bytecod3/Hydros/hardware/hydros-v1-png-top.png

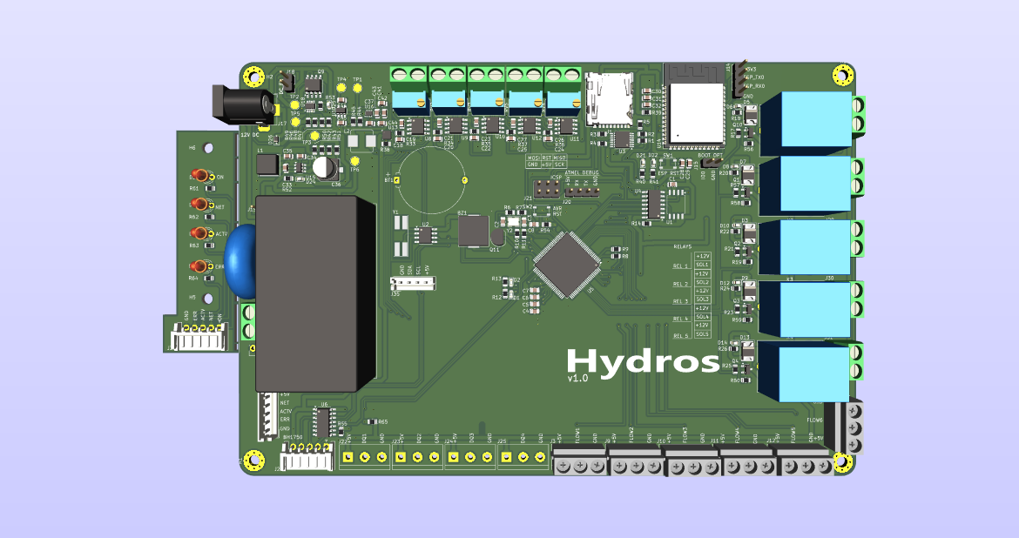
hardware/hydros-v1-png-top.png
