bytecod3/Hydros/hardware/hydros-v1-png.png

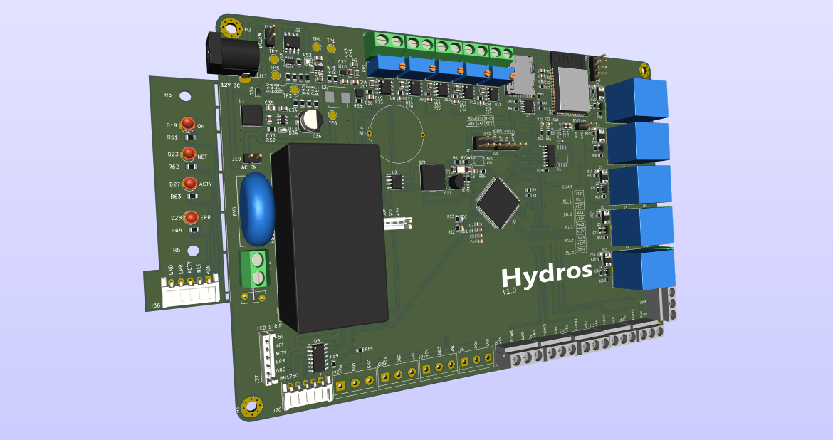
hardware/hydros-v1-png.png
