bytecod3/Hydros/README.md

### Introduction
Hydros

### Enabling floating point on MicroChip Studio 7
Refer to this article:
https://startingelectronics.org/articles/atmel-AVR-8-bit/print-float-atmel-studio-7/
