bytecod3/Hydros/hydro-switch/assets/system-diagram.pdf

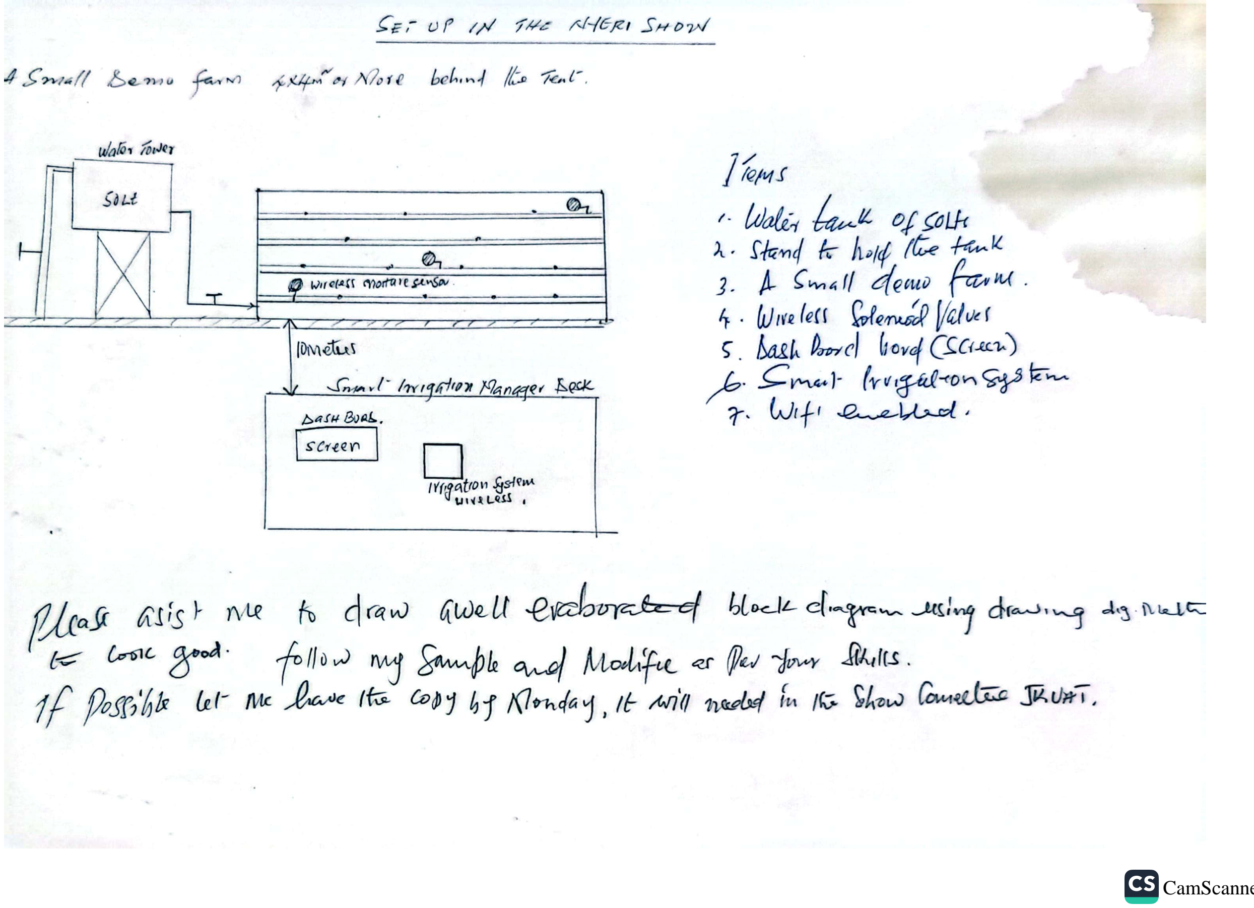
[picture p3: page 1]

CamScanner (https://v3.camscanner.com/user/download)
