bytecod3/Hydros/brainstorm/psu-1.jpg

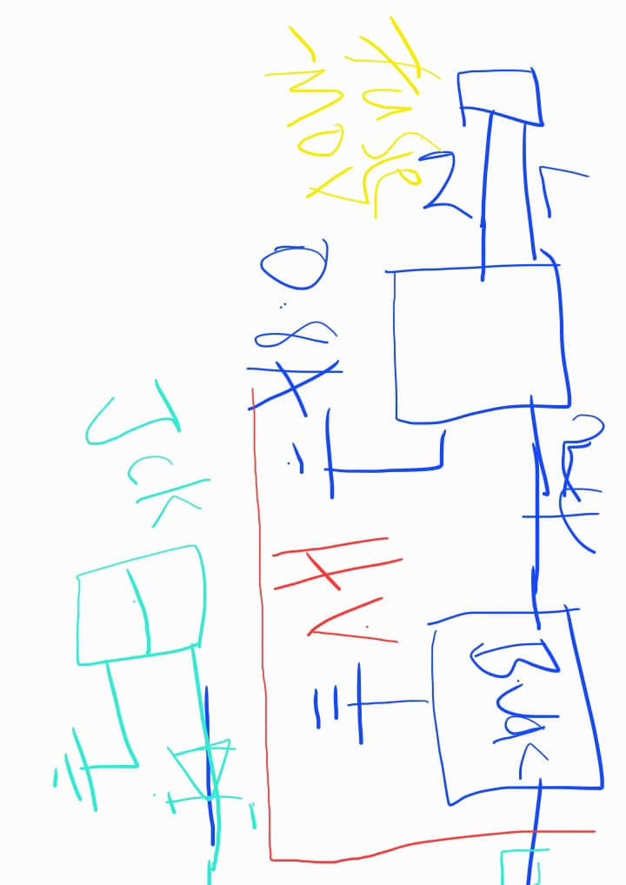
brainstorm/psu-1.jpg
