bytecod3/Hydros/brainstorm/psu-2.jpg

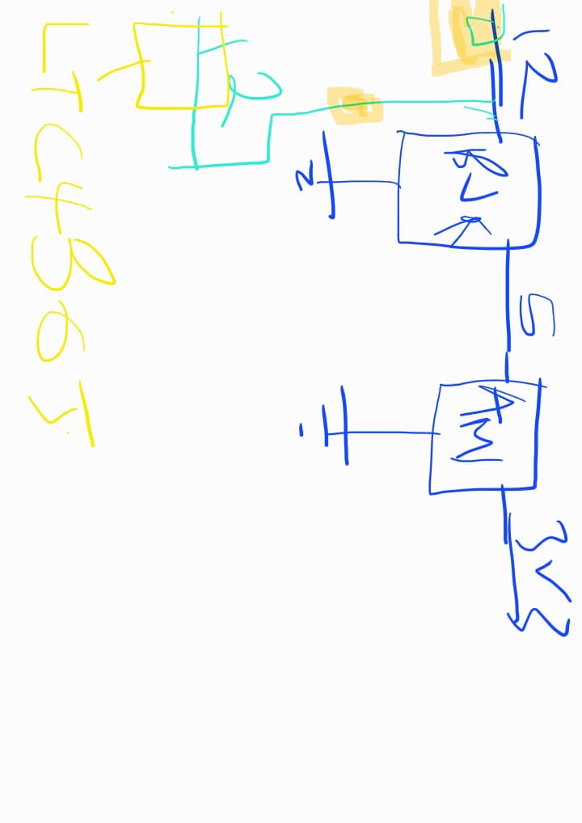
brainstorm/psu-2.jpg
