bytecod3/Hydros/hydro-switch/assets/ortho.png

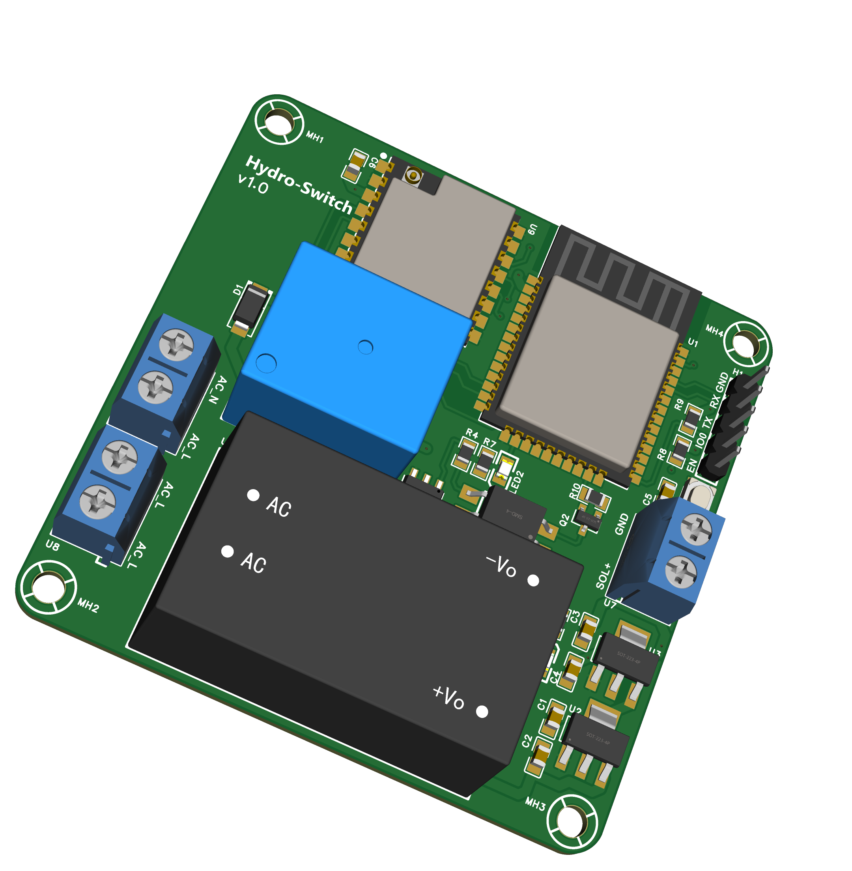
hydro-switch/assets/ortho.png
