bytecod3/Hydros/hydro-switch/assets/solenoid-2.jpg

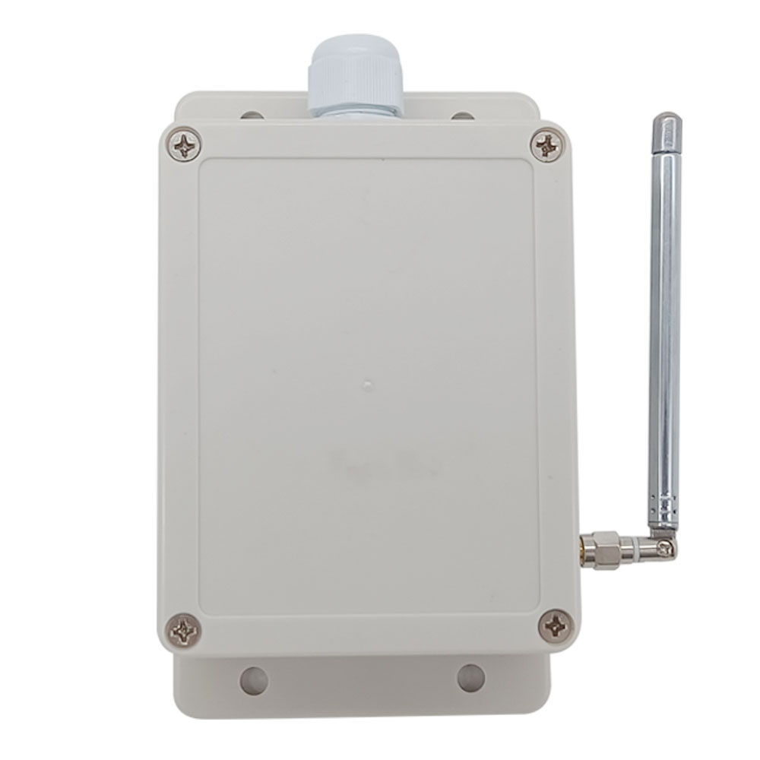
hydro-switch/assets/solenoid-2.jpg
