bytecod3/Hydros/hydro-switch/assets/solenoid-3.jpg

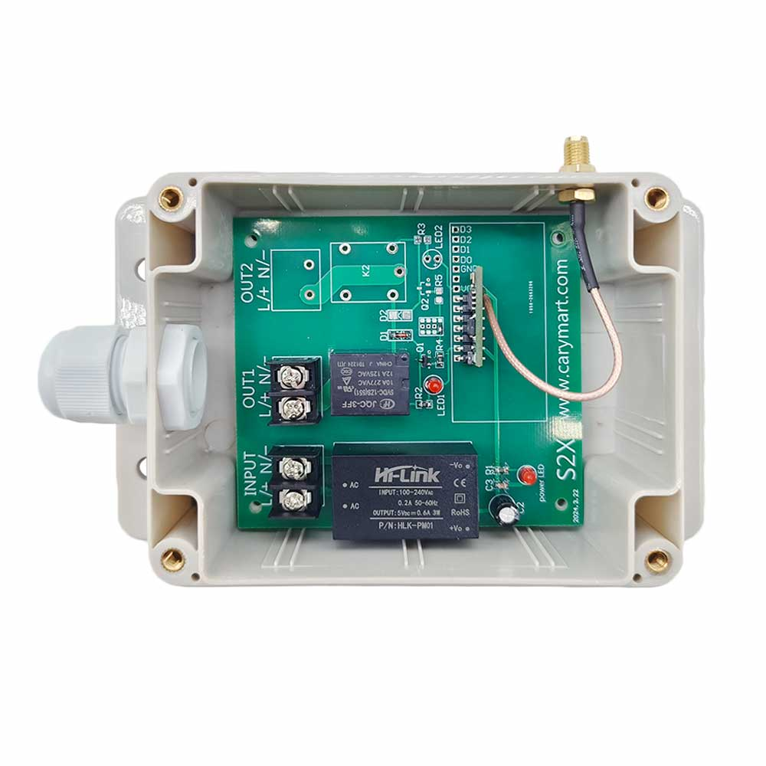
hydro-switch/assets/solenoid-3.jpg
