bytecod3/Hydros/hydro-switch/assets/solenoid-cct.jpg

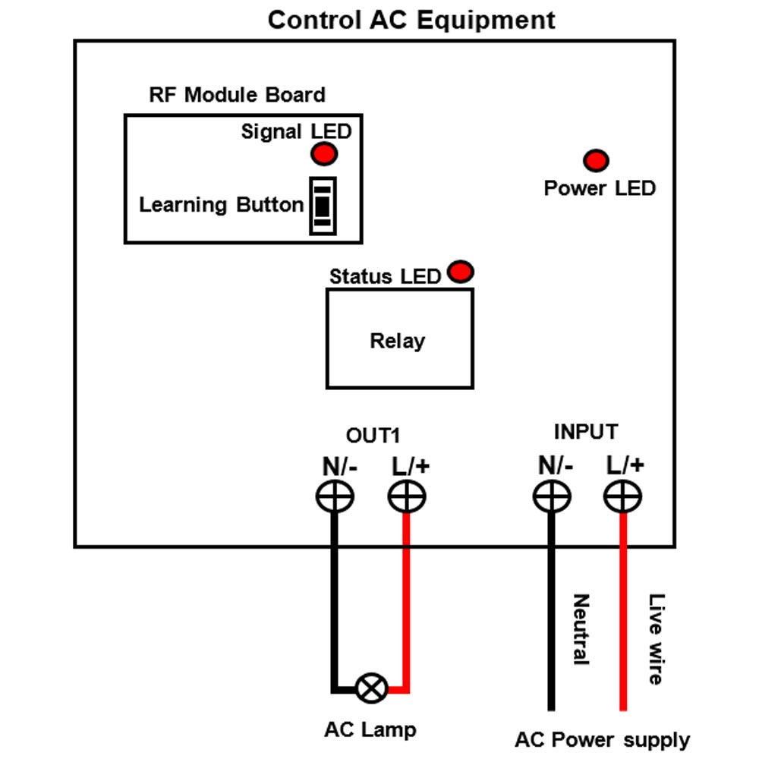
hydro-switch/assets/solenoid-cct.jpg
