bytecod3/Hydros/hydro-switch/assets/solenoid.jpg

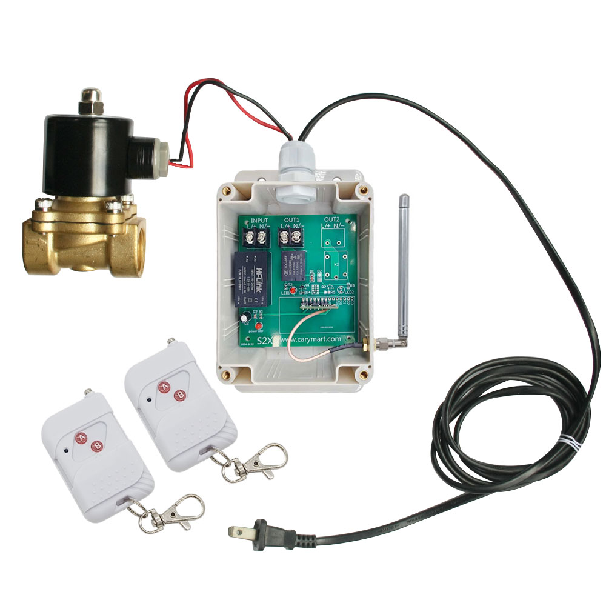
hydro-switch/assets/solenoid.jpg
