bytecod3/Hydros/hydro-switch/assets/top.png

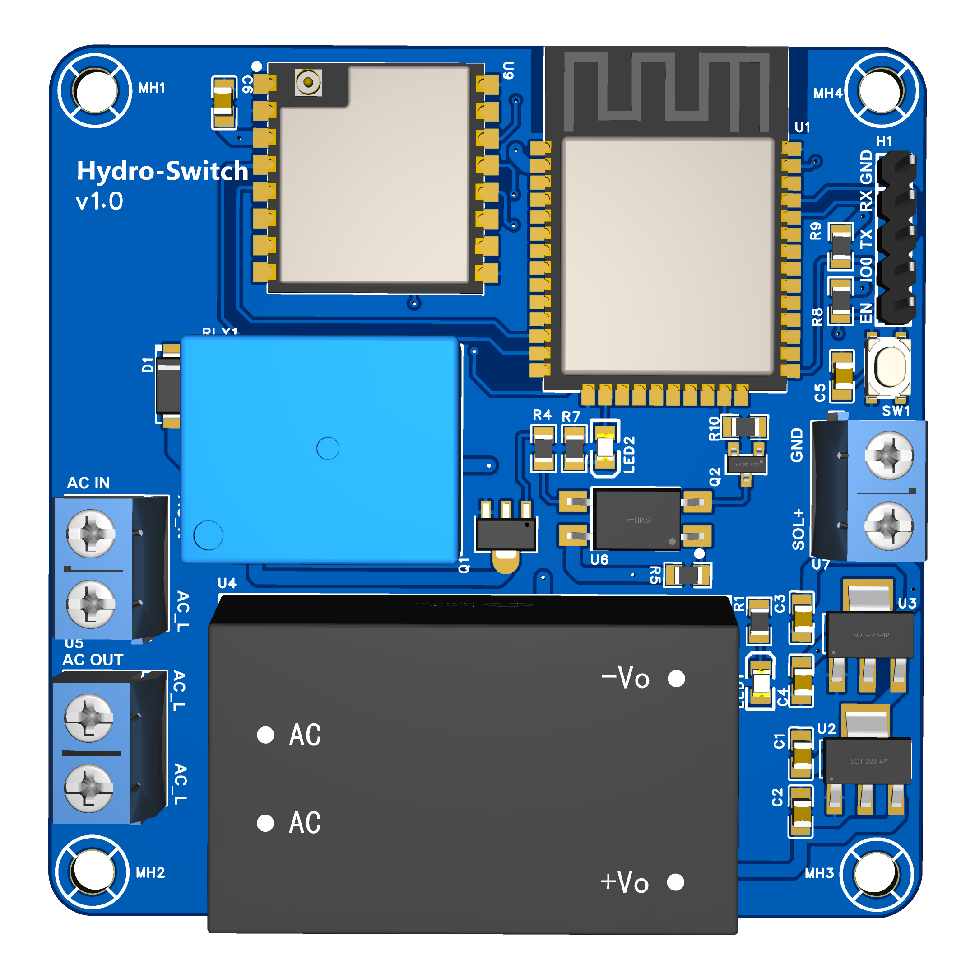
hydro-switch/assets/top.png
