bytecod3/Hydros/hydro-switch/assets/wireless-solenoid-valve.png

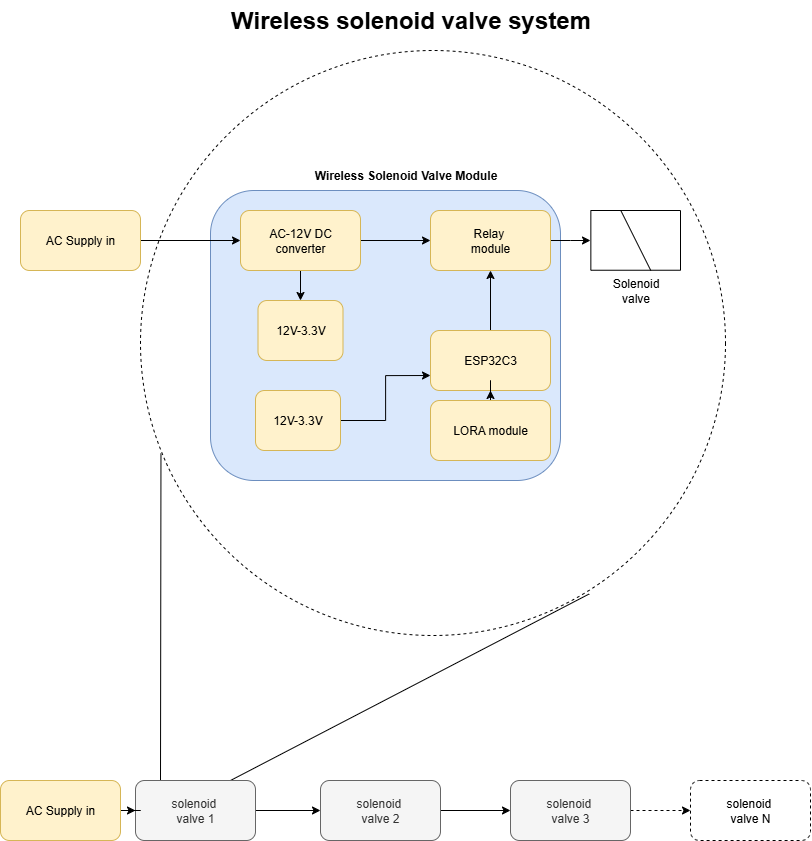
hydro-switch/assets/wireless-solenoid-valve.png
