bytecod3/Hydros/images/home-side.png

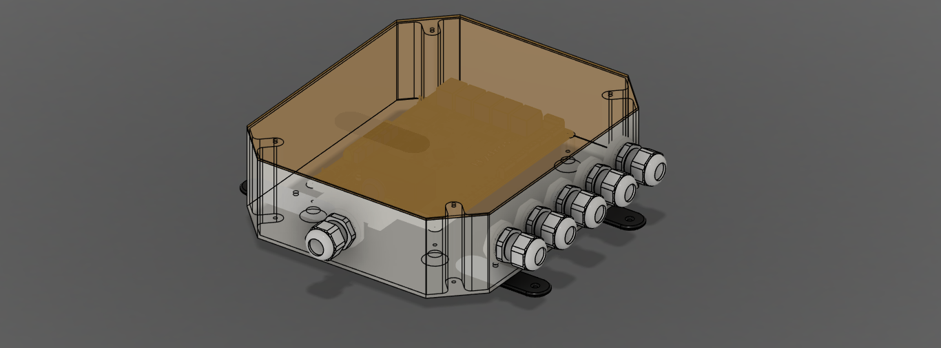
images/home-side.png
