bytecod3/Hydros/images/home.png

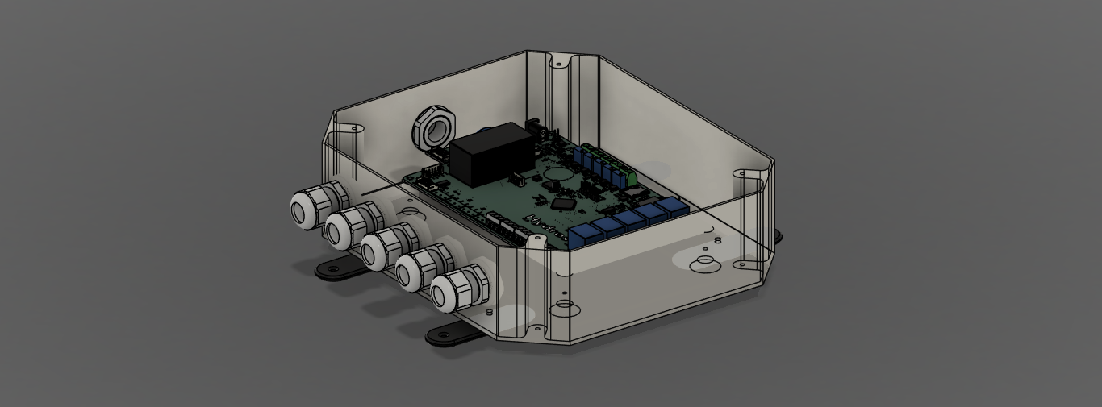
images/home.png
