bytecod3/Hydros/images/top.png

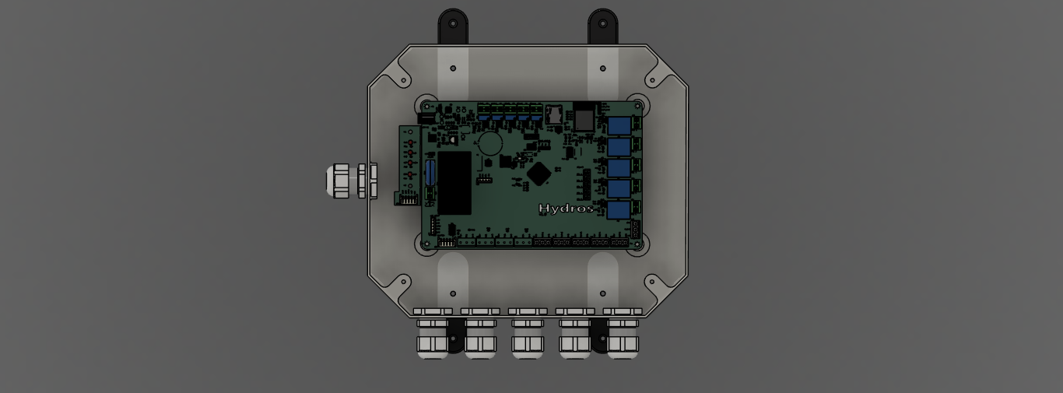
images/top.png
