bytecod3/Hydros/hydro-switch/assets/smart-irrigation-manager-setup.png

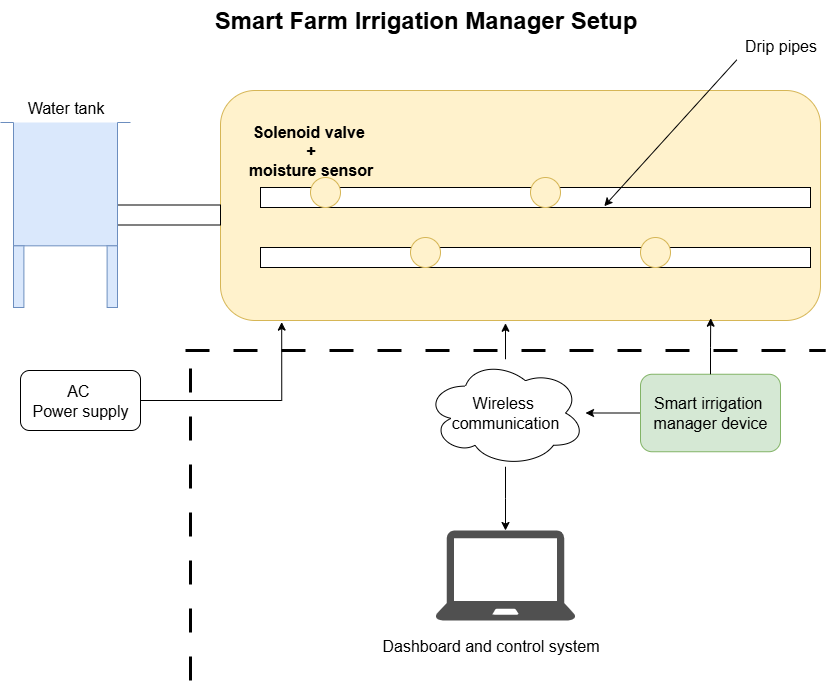
hydro-switch/assets/smart-irrigation-manager-setup.png
