bytecod3/Hydros/hydro-switch/schematics/hydroswitch-v1.pdf

POWER SUPPLY | DEBUG HEADER

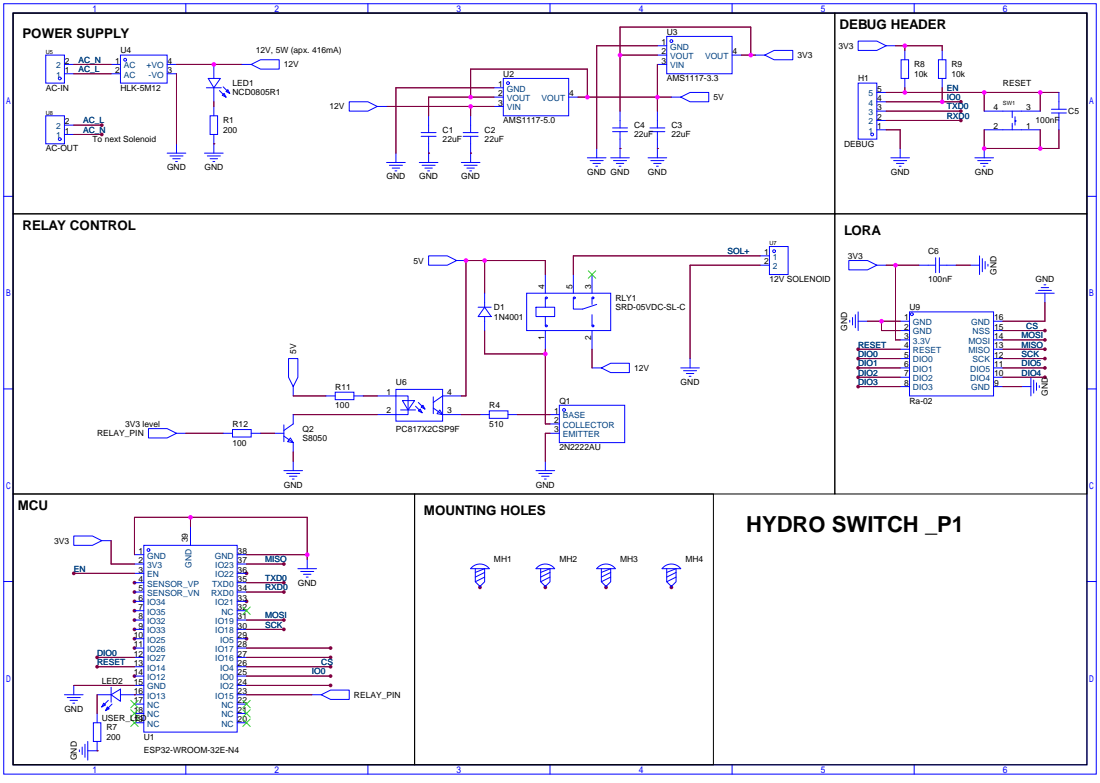
[picture p17: page 1]

DIO4 10 DIO5 11 SCK 12 MISO 13 MOSI 14 NSS 15 GND 16
