bytecod3/Hydros/(list of files, drawings)

Other design files:
simulations/CPU-ORing-cct.ms11
