bytecod3/Hydros/hardware/smart-irrigation-manager.kicad_pcb

## KiCad design hardware/smart-irrigation-manager.kicad_pcb (2025-06-19)

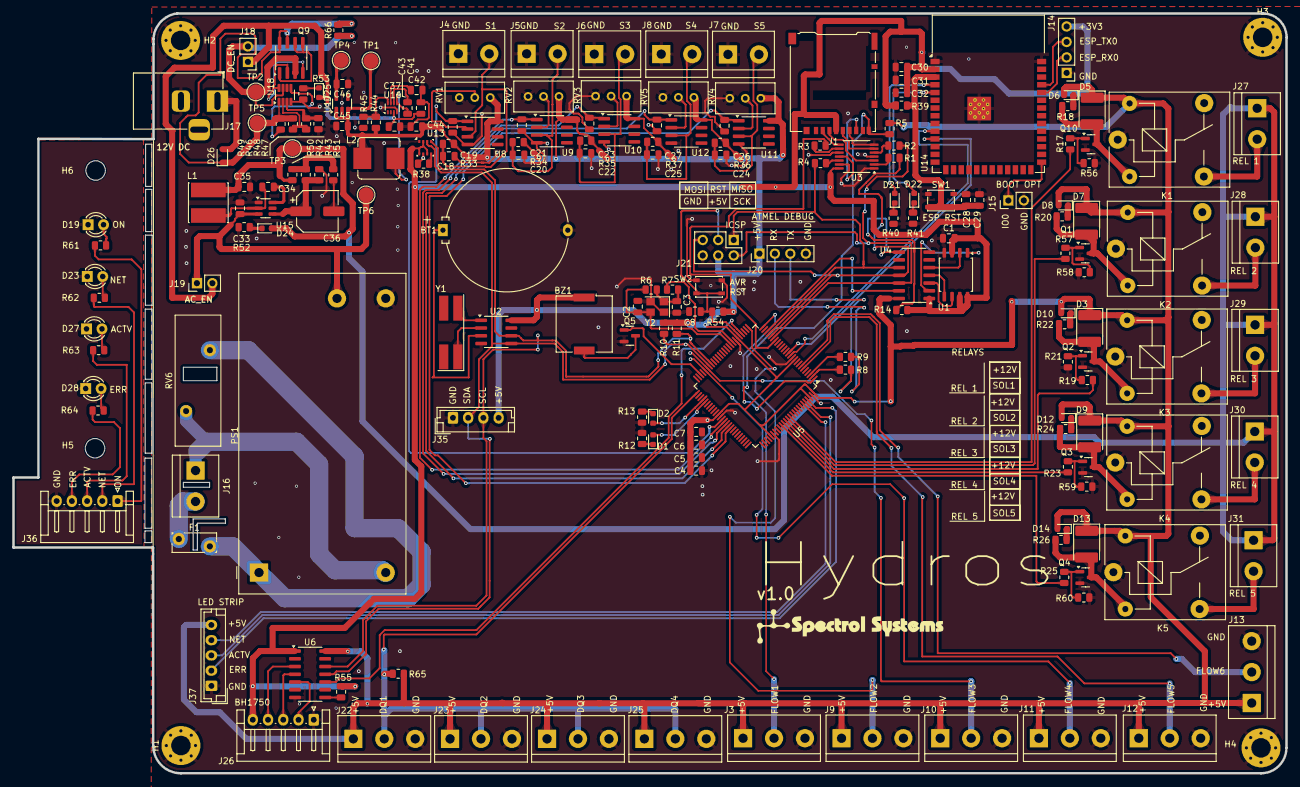
[picture p18: board smart-irrigation-manager.kicad_pcb from above]

Board: 2 copper layers, 209.0 x 124.7 mm, 203 parts (0 on the bottom side), 142 nets.

Parts:
BT1: 3V Coin Cell - CR2032; Battery_Panasonic_CR2032-HFN_Horizontal_CircularHoles
BZ1: Buzzer; Buzzer_Murata_PKMCS0909E
C1, C4, C5, C6, C7, C8, C18, C19, C20, C21, C22, C23, C24, C25, C26, C27, C28, C30, C34, C37, C43: 100nF; C_0805_2012Metric
C2, C3: 15pF; C_0805_2012Metric
C29, C32: 1uF; C_0805_2012Metric
C31: 22uF; C_0805_2012Metric
C33: 2.22uF; C_0805_2012Metric
C35: 44uF/47uF; C_0805_2012Metric
C36: 100uF; CP_Elec_6.3x5.7
C41: 10uF; C_0805_2012Metric
C42: 33nF; C_0805_2012Metric
C44, C45, C46: 47uF; C_0805_2012Metric
D1, D2, D6, D8, D10, D12, D14, D21, D22, D25: LED; LED_0603_1608Metric
D3, D5, D7, D9, D13: 1N4007; D_2114_3652Metric
D19: RED LED - ON; LED_D3.0mm
D23: GREEN LED - NET; LED_D3.0mm
D24: RED; LED_0603_1608Metric
D26: BAT54J; D_SOD-323F
D27: YELLOW LED -OPER; LED_D3.0mm
D28: RED LED - ERR; LED_D3.0mm
F1: 5A/Resetable(PPTC) - RUEF300; Fuse_Bourns_MF-RG300
H1, H2, H3, H4: MountingHole_Pad; MountingHole_3.2mm_M3_Pad_Via
H5, H6: MountingHole; MountingHole_3.2mm_M3
J1: Micro_SD_Card_Det1; microSD_HC_Hirose_DM3AT-SF-PEJM5
J3, J9, J10, J11, J12, J13: Flow Meter; TerminalBlock_bornier-3_P5.08mm
J4: Soil Moisture Sensor 1; TerminalBlock_bornier-2_P5.08mm
J5: Soil Moisture Sensor 2; TerminalBlock_bornier-2_P5.08mm
J6: Soil Moisture Sensor 3; TerminalBlock_bornier-2_P5.08mm
J7: Soil Moisture Sensor 5; TerminalBlock_bornier-2_P5.08mm
J8: Soil Moisture Sensor 4; TerminalBlock_bornier-2_P5.08mm
J14: ESP-PROG; PinHeader_1x04_P2.54mm_Vertical
J15: BOOT-OPTION; PinHeader_1x02_P2.54mm_Vertical
J16: AC IN; TerminalBlock_bornier-2_P5.08mm
J17: Jack-DC; BarrelJack_Horizontal
J18: DC_EN; PinHeader_1x02_P2.54mm_Vertical
J19: AC_EN; PinHeader_1x02_P2.54mm_Vertical
J20: FTDI_PROGRAMMER; PinHeader_1x04_P2.54mm_Vertical
J21: ICSP; PinHeader_2x03_P2.54mm_Vertical
J22: DS18B20_1; TerminalBlock_bornier-3_P5.08mm
J23: DS18B20_2; TerminalBlock_bornier-3_P5.08mm
J24: DS18B20_3; TerminalBlock_bornier-3_P5.08mm
J25: DS18B20_4; TerminalBlock_bornier-3_P5.08mm
J26: BH1750 LIGHT; JST_EH_S5B-EH_1x05_P2.50mm_Horizontal
J27: REL1_TERMINAL; TerminalBlock_bornier-2_P5.08mm
J28: REL2_TERMINAL; TerminalBlock_bornier-2_P5.08mm
J29: REL3_TERMINAL; TerminalBlock_bornier-2_P5.08mm
J30: REL4_TERMINAL; TerminalBlock_bornier-2_P5.08mm
J31: REL5_TERMINAL; TerminalBlock_bornier-2_P5.08mm
J35: 20x4 LCD connector; JST_EH_B4B-EH-A_1x04_P2.50mm_Vertical
J36: LED_UI_CONNECTOR; JST_EH_S5B-EH_1x05_P2.50mm_Horizontal
J37: LED_UI_CONNECTOR; JST_EH_B5B-EH-A_1x05_P2.50mm_Vertical
K1, K2, K3, K4, K5: SANYOU_SRD_Form_C; Relay_SPDT_SANYOU_SRD_Series_Form_C
L1: 22uH; L_Cenker_CKCS6020
L2: 10uH; L_Bourns_SRP7028A_7.3x6.6mm
PS1: IRM-20-24; Converter_ACDC_MeanWell_IRM-20-xx_THT
Q1, Q2, Q3, Q4, Q10: AO3400A; SOT-23
Q5: BC846; SOT-23
Q9: Si4532DY; SOIC-8_3.9x4.9mm_P1.27mm
R1, R2, R3, R4: 3.3K; R_0805_2012Metric
R5, R21, R33, R34, R35, R36, R37, R38, R56, R58, R59, R60: 10K; R_0805_2012Metric
R6: 1M; R_0805_2012Metric
R7: 27R; R_0805_2012Metric
R8, R9: 22R; R_0805_2012Metric
R10, R11, R14, R54, R55, R65: 4.7k; R_0805_2012Metric
R12, R13, R18, R20, R22, R24, R26: R_500_0805; R_0805_2012Metric
R17, R19, R23, R25, R52, R53, R57: 500R; R_0805_2012Metric
R39, R45: 10K_0805; R_0805_2012Metric
R40, R41: 500R_0805; R_0805_2012Metric
R42: 100K_0805; R_0805_2012Metric
R43: 5.23K_0805; R_0805_2012Metric
R44: 52.3K_0805; R_0805_2012Metric
R46: 243K; R_0805_2012Metric
R47: 59K; R_0805_2012Metric
R48: 1820K; R_0805_2012Metric
R49: 510K_0805; R_0805_2012Metric
R50: 49.9R_0805; R_0805_2012Metric
R51: 2K_0805; R_0805_2012Metric
R61, R62, R63, R64: 270R; R_0805_2012Metric
R66: 0R; R_0805_2012Metric
RV1, RV2, RV3, RV4, RV5: 100K; Potentiometer_Bourns_3296W_Vertical
RV6: 14D471K; RV_Disc_D21.5mm_W7.5mm_P10mm
SW1: RESET; SW_SPST_PTS810
SW2: ATMEL_RST; SW_SPST_PTS810
TP1: 5V_TP; TestPoint_Pad_D2.5mm
TP2: 12V_TP; TestPoint_Pad_D2.5mm
TP3: 12V_AC_TP; TestPoint_Pad_D2.5mm
TP4: 3V3_TP; TestPoint_Pad_D2.5mm
TP5: 12V_DC_TP; TestPoint_Pad_D2.5mm
TP6: 24V_AC_TP; TestPoint_Pad_D2.5mm
U1: W25Q32JVSS; SOIC-8_5.23x5.23mm_P1.27mm
U2: DS1307Z+; SOIC-8_3.9x4.9mm_P1.27mm
U3: 74LVC125; TSSOP-14_4.4x5mm_P0.65mm
U4, U6: TXB0104D; SOIC-14_3.9x8.7mm_P1.27mm
U5: ATmega2560-16A; TQFP-100_14x14mm_P0.5mm
U8, U9, U10, U11, U12: LM393; SOIC-8_3.9x4.9mm_P1.27mm
U13: BME280; Bosch_LGA-8_2.5x2.5mm_P0.65mm_ClockwisePinNumbering
U14: ESP32-S3-WROOM-1
U15: TPS54308; SOT-23-6
U16: TPS62932; SOT-583-8
U17: TLV75533PDBV; SOT-23-5
U18: LTC4365TS8; TSOT-23-8
Y1: 32.768kHz; Crystal_SMD_SeikoEpson_MC406-4Pin_9.6x4.1mm
Y2: 16MHz; Crystal_SMD_3225-4Pin_3.2x2.5mm

Connections:
+3.3V: C46.2, TP4.1, U17.5 (OUT)
+3V3: C1.2, C30.2, C31.2, C32.2, J1.4 (VDD), J14.4, J26.5, R14.2, R39.1, R55.2, U1.3 (IO2), U1.7 (IO3), U1.8 (VCC), U3.14 (VCC), U4.1 (VCCA), U6.1 (VCCA), U13.2 (CSB), U13.6 (VDDIO), U13.8 (VDD), U14.2 (3V3)
+5V: BZ1.1 (+), C4.2, C5.2, C6.2, C7.2, C44.2, C45.2, D3.1 (K), D5.1 (K), D6.2 (A), D7.1 (K), D8.2 (A), D9.1 (K), D10.2 (A), D12.2 (A), D13.1 (K), D14.2 (A), J3.1, J9.1, J10.1, J11.1, J12.1, J13.1, J20.1, J21.4, J22.1, J23.1, J24.1, J25.1, J35.4, J37.5, K1.5, K2.5, K3.5, K4.5, K5.5, L2.2, R5.2, R10.2, R11.2, R33.2, R34.2, R35.2, R36.2, R37.2, R44.1, R54.2, R65.2, RV1.1, RV2.1, RV3.1, RV4.1, RV5.1, TP1.1, U2.8 (VCC), U4.14 (VCCB), U5.10 (VCC), U5.31 (VCC), U5.61 (VCC), U5.80 (VCC), U5.98 (AREF), U5.100 (AVCC), U6.14 (VCCB), U8.8 (V+), U9.8 (V+), U10.8 (V+), U11.8 (V+), U12.8 (V+), U17.1 (IN), U17.3 (EN)
+12V: C35.2, D24.2 (A), J27.1, J28.1, J29.1, J30.1, J31.1, L1.2, R50.1, TP3.1
+24V: C33.1, J19.1, PS1.4 (+Vo), TP6.1, U15.3 (VIN)
/Master/CPU_SECTION/BUZZER: Q5.1 (B), U5.48 (PD5)
/Master/CPU_SECTION/FTDI_RX: J20.2, R9.2
/Master/CPU_SECTION/FTDI_TX: J20.3, R8.2
/Master/CPU_SECTION/F_CLK: U1.6 (CLK), U4.3 (A2)
/Master/CPU_SECTION/F_CS: U1.1 (~CS), U4.2 (A1)
/Master/CPU_SECTION/F_MISO: U1.2 (DO(IO1)), U4.5 (A4)
/Master/CPU_SECTION/F_MOSI: U1.5 (DI(IO0)), U4.4 (A3)
/Master/CPU_SECTION/RXD0: R8.1, U5.2 (PE0)
/Master/CPU_SECTION/SD_CLK: J1.5 (CLK), U3.6
/Master/CPU_SECTION/SD_CS: J1.2 (DAT3/CD), U3.8
/Master/CPU_SECTION/SD_MISO: J1.7 (DAT0), U3.11
/Master/CPU_SECTION/SD_MOSI: J1.3 (CMD), U3.3
/Master/CPU_SECTION/TXD0: R9.1, U5.3 (PE1)
/Master/CPU_SECTION/USER_LED1: D2.2 (A), U5.54 (PC1)
/Master/CPU_SECTION/USER_LED2: D1.2 (A), U5.55 (PC2)
/Master/OUTPUT_CONTROL/REL1_PULSE: D5.2 (A), K1.2, Q10.3 (D), R18.1
/Master/OUTPUT_CONTROL/REL2_PULSE: D7.2 (A), K2.2, Q1.3 (D), R20.1
/Master/OUTPUT_CONTROL/REL3_PULSE: D3.2 (A), K3.2, Q2.3 (D), R22.1
/Master/OUTPUT_CONTROL/REL4_PULSE: D9.2 (A), K4.2, Q3.3 (D), R24.1
/Master/OUTPUT_CONTROL/REL5_PULSE: D13.2 (A), K5.2, Q4.3 (D), R26.1
/Master/POWER SUPPLY UNIT/12V_DC: J18.2, Q9.3 (1), R66.1, TP2.1, U18.7 (Vout)
/Master/POWER SUPPLY UNIT/AC_IN: F1.2, PS1.1 (AC/L), RV6.1
/Master/POWER SUPPLY UNIT/L_IN: F1.1, J16.2
/Master/POWER SUPPLY UNIT/N_IN: J16.1, PS1.2 (AC/N), RV6.2
/Master/SENSORS AND INPUTS/LIGHT_ADDR: J26.2, U6.5 (A4)
/Master/SENSORS AND INPUTS/LIGHT_SCL: J26.4, U6.3 (A2)
/Master/SENSORS AND INPUTS/LIGHT_SDA: J26.3, U6.4 (A3)
/Master/WIFI AND COMMS/ESP_EN: C28.2, C29.2, R39.2, SW1.2, U14.3 (EN)
/Master/WIFI AND COMMS/ESP_RX0: J14.2, U14.36 (RXD0)
/Master/WIFI AND COMMS/ESP_TX0: J14.3, U14.37 (TXD0)
/Master/WIFI AND COMMS/USER_LED1: D21.2 (A), U14.4 (IO4)
/Master/WIFI AND COMMS/USER_LED2: D22.2 (A), U14.5 (IO5)
BH1750_ADDR: U5.29 (PG4), U6.10 (B4)
ESP_RX1: U5.13 (PH1), U14.11 (IO18)
ESP_TX1: U5.12 (PH0), U14.10 (IO17)
FLOW_METER_1: J3.2, U5.25 (PB6)
FLOW_METER_2: J9.2, U5.26 (PB7)
FLOW_METER_3: J10.2, U5.45 (PD2)
FLOW_METER_4: J11.2, U5.46 (PD3)
FLOW_METER_5: J12.2, U5.6 (PE4)
FLOW_METER_6: J13.2, U5.7 (PE5)
GND: BT1.2 (-), C1.1, C2.1, C3.1, C4.1, C5.1, C6.1, C7.1, C8.1, C18.2, C19.2, C20.2, C21.2, C22.2, C23.2, C24.2, C25.2, C26.2, C27.2, C28.1, C29.1, C30.1, C31.1, C32.1, C33.2, C35.1, C37.2, C41.2, C42.2, C44.1, C45.1, C46.1, H1.1, H2.1, H3.1, H4.1, J1.6 (VSS), J3.3, J4.1, J5.1, J6.1, J7.1, J8.1, J9.3, J10.3, J11.3, J12.3, J13.3, J14.1, J15.2, J17.2, J20.4, J21.6, J22.3, J23.3, J24.3, J25.3, J26.1, J35.1, J37.1, K1.1, K2.1, K3.1, K4.1, K5.1, PS1.3 (-Vo), Q1.2 (S), Q2.2 (S), Q3.2 (S), Q4.2 (S), Q5.2 (E), Q10.2 (S), R12.1, R13.1, R21.1, R38.2, R40.1, R41.1, R43.2, R45.2, R47.2, R52.2, R53.2, R56.1, R58.1, R59.1, R60.1, RV1.3, RV2.3, RV3.3, RV4.3, RV5.3, SW1.1, SW2.1, U1.4 (GND), U2.4 (GND), U3.1, U3.4, U3.7 (GND), U3.10, U3.13, U4.7 (GND), U5.11 (GND), U5.32 (GND), U5.62 (GND), U5.81 (GND), U5.99 (GND), U6.7 (GND), U8.4 (V-), U9.4 (V-), U10.4 (V-), U11.4 (V-), U12.4 (V-), U13.1 (GND), U13.7 (GND), U14.1 (GND), U14.40 (GND), U14.41 (GND), U15.1 (GND), U16.4 (GND), U17.2 (GND), U18.4 (GND), Y2.2, Y2.4
GREEN_NET: J37.4, U5.95 (PF2)
MCU_FLASH_CS: U4.13 (B1), U5.23 (PB4)
MCU_SD_CS: R3.1, U5.19 (PB0)
unnamed: BT1.1 (+), U2.3 (VBAT)
unnamed: BZ1.2 (-), Q5.3 (C)
unnamed: C3.2, R6.2, R7.1, Y2.1
unnamed: C36.2, R51.1
unnamed: D1.1 (K), R12.2
unnamed: D2.1 (K), R13.2
unnamed: D6.1 (K), R18.2
unnamed: D8.1 (K), R20.2
unnamed: D10.1 (K), R22.2
unnamed: D12.1 (K), R24.2
unnamed: D14.1 (K), R26.2
unnamed: D19.2 (A), R61.2
unnamed: D19.1 (K), D23.1 (K), D27.1 (K), D28.1 (K), J36.5
unnamed: D21.1 (K), R40.2
unnamed: D22.1 (K), R41.2
unnamed: D23.2 (A), R62.2
unnamed: D24.1 (K), R52.1
unnamed: C37.1, C41.1, D25.2 (A), J18.1, J19.2, U16.3 (VIN)
unnamed: D25.1 (K), R53.1
unnamed: D26.2 (A), J17.1
unnamed: D26.1 (K), Q9.7 (D), Q9.8 (D), R48.1, R49.1, R66.2, TP5.1, U18.1 (Vin)
unnamed: D27.2 (A), R63.2
unnamed: D28.2 (A), R64.2
unnamed: C18.1, J4.2, R33.1, U8.3 (+)
unnamed: C20.1, J5.2, R34.1, U9.3 (+)
unnamed: C22.1, J6.2, R35.1, U10.3 (+)
unnamed: C24.1, J7.2, R36.1, U11.3 (+)
unnamed: C25.1, J8.2, R37.1, U12.3 (+)
unnamed: J15.1, U14.27 (IO0)
unnamed: J27.2, K1.3
unnamed: J28.2, K2.3
unnamed: J29.2, K3.3
unnamed: J30.2, K4.3
unnamed: J31.2, K5.3
unnamed: J36.1, R61.1
unnamed: J36.2, R62.1
unnamed: J36.3, R63.1
unnamed: J36.4, R64.1
unnamed: Q1.1 (G), R57.2, R58.2
unnamed: Q2.1 (G), R19.2, R21.2
unnamed: Q3.1 (G), R23.2, R59.2
unnamed: Q4.1 (G), R25.2, R60.2
unnamed: Q9.2 (G), Q9.4 (G), U18.8 (GATE)
unnamed: Q9.1 (S), Q9.5 (D), Q9.6 (D)
unnamed: Q10.1 (G), R17.2, R56.2
unnamed: R1.2, U3.2
unnamed: R2.2, U3.5
unnamed: R3.2, U3.9
unnamed: R4.2, U3.12
unnamed: R42.1, R50.2, R51.2
unnamed: U2.1 (X1), Y1.2
unnamed: U2.2 (X2), Y1.1
unnamed: R14.1, U4.8 (OE)
unnamed: C2.2, R6.1, U5.34 (XTAL1), Y2.3
unnamed: R7.2, U5.33 (XTAL2)
unnamed: R55.1, U6.8 (OE)
unnamed: RV1.2, U8.2 (-)
unnamed: RV2.2, U9.2 (-)
unnamed: RV3.2, U10.2 (-)
unnamed: RV4.2, U11.2 (-)
unnamed: RV5.2, U12.2 (-)
unnamed: R38.1, U13.5 (SDO)
unnamed: C34.1, U15.6 (BOOT)
unnamed: C36.1, R42.2, R43.1, U15.4 (FB)
unnamed: C34.2, L1.1, U15.2 (SW)
unnamed: C43.1, U16.6 (BST)
unnamed: R44.2, R45.1, U16.8 (FB)
unnamed: C42.1, U16.7 (SS)
unnamed: C43.2, L2.1, U16.5 (SW)
unnamed: R46.2, R47.1, U18.3 (OV)
unnamed: R46.1, R48.2, U18.2 (UV)
unnamed: R49.2, U18.5 (~SHDN)
RED_ERR: J37.2, U5.97 (PF0)
REL1_SIG: R17.1, U5.89 (PK0)
REL2_SIG: R57.1, U5.88 (PK1)
REL3_SIG: R19.1, U5.87 (PK2)
REL4_SIG: R23.1, U5.86 (PK3)
REL5_SIG: R25.1, U5.85 (PK4)
RESET: C8.2, J21.3, R54.1, SW2.2, U5.30 (~RESET)
SCL: J35.3, R11.1, U2.6 (SCL), U5.43 (PD0), U6.12 (B2), U13.4 (SCK)
SDA: J35.2, R10.1, U2.5 (SDA), U5.44 (PD1), U6.11 (B3), U13.3 (SDI)
SD_DETECT: J1.9 (DET), R5.1, U5.1 (PG5)
SOIL_SIG1: C19.1, U5.63 (PJ0), U8.1
SOIL_SIG2: C21.1, U5.64 (PJ1), U9.1
SOIL_SIG3: C23.1, U5.65 (PJ2), U10.1
SOIL_SIG4: C27.1, U5.66 (PJ3), U12.1
SOIL_SIG5: C26.1, U5.67 (PJ4), U11.1
SPI_MISO: J21.1, R4.1, U4.10 (B4), U5.22 (PB3)
SPI_MOSI: J21.5, R1.1, U4.11 (B3), U5.21 (PB2)
SPI_SCK: J21.2, R2.1, U4.12 (B2), U5.20 (PB1)
TEMP: J22.2, J23.2, J24.2, J25.2, R65.1, U5.51 (PG0)
YELLOW_OPER: J37.3, U5.96 (PF1)
