bytecod3/Hydros/firmware/atmega2560/avr-solution/hydros-v1-firmware/flow-meter.h

/*
 * flow_meter.h
 *
 * Created: 6/6/2025 2:56:55 PM
 *  Author: user
 */ 


#ifndef FLOW_METER_H_
#define FLOW_METER_H_

void flow_meter_interrupt_init();
float flow_meter_get_flow_rate(int);



#endif /* FLOW-METER_H_ */
