bytecod3/Hydros/(commit log)

2025-06-11 ADDS non-blocking delay
    [CPU-ORing-cct.ms11, cpu_section.kicad_sch, master.kicad_sch, output_control.kicad_sch, power-supply-unit.kicad_sch, sensors_and_inputs.kicad_sch, smart-irrigation-manager.kicad_pcb, smart-irrigation-manager.kicad_sch]
2025-06-12 ADDS CTC timer
2025-06-14 ADDS flow meter calculation
    [cpu_section.kicad_sch]
2025-06-17 ADDS temp sensor code
2025-06-19 ADDS production files
    [bom.csv, cpu_section.kicad_sch, designators.csv, hdros-bom-6-19-2025.csv, master.kicad_sch, output_control.kicad_sch, positions.csv, power-supply-unit.kicad_sch]
2025-08-07 ADDS relay control hdroswitch
